DerULF1/8bit-computer/Schematics/memory2.pdf

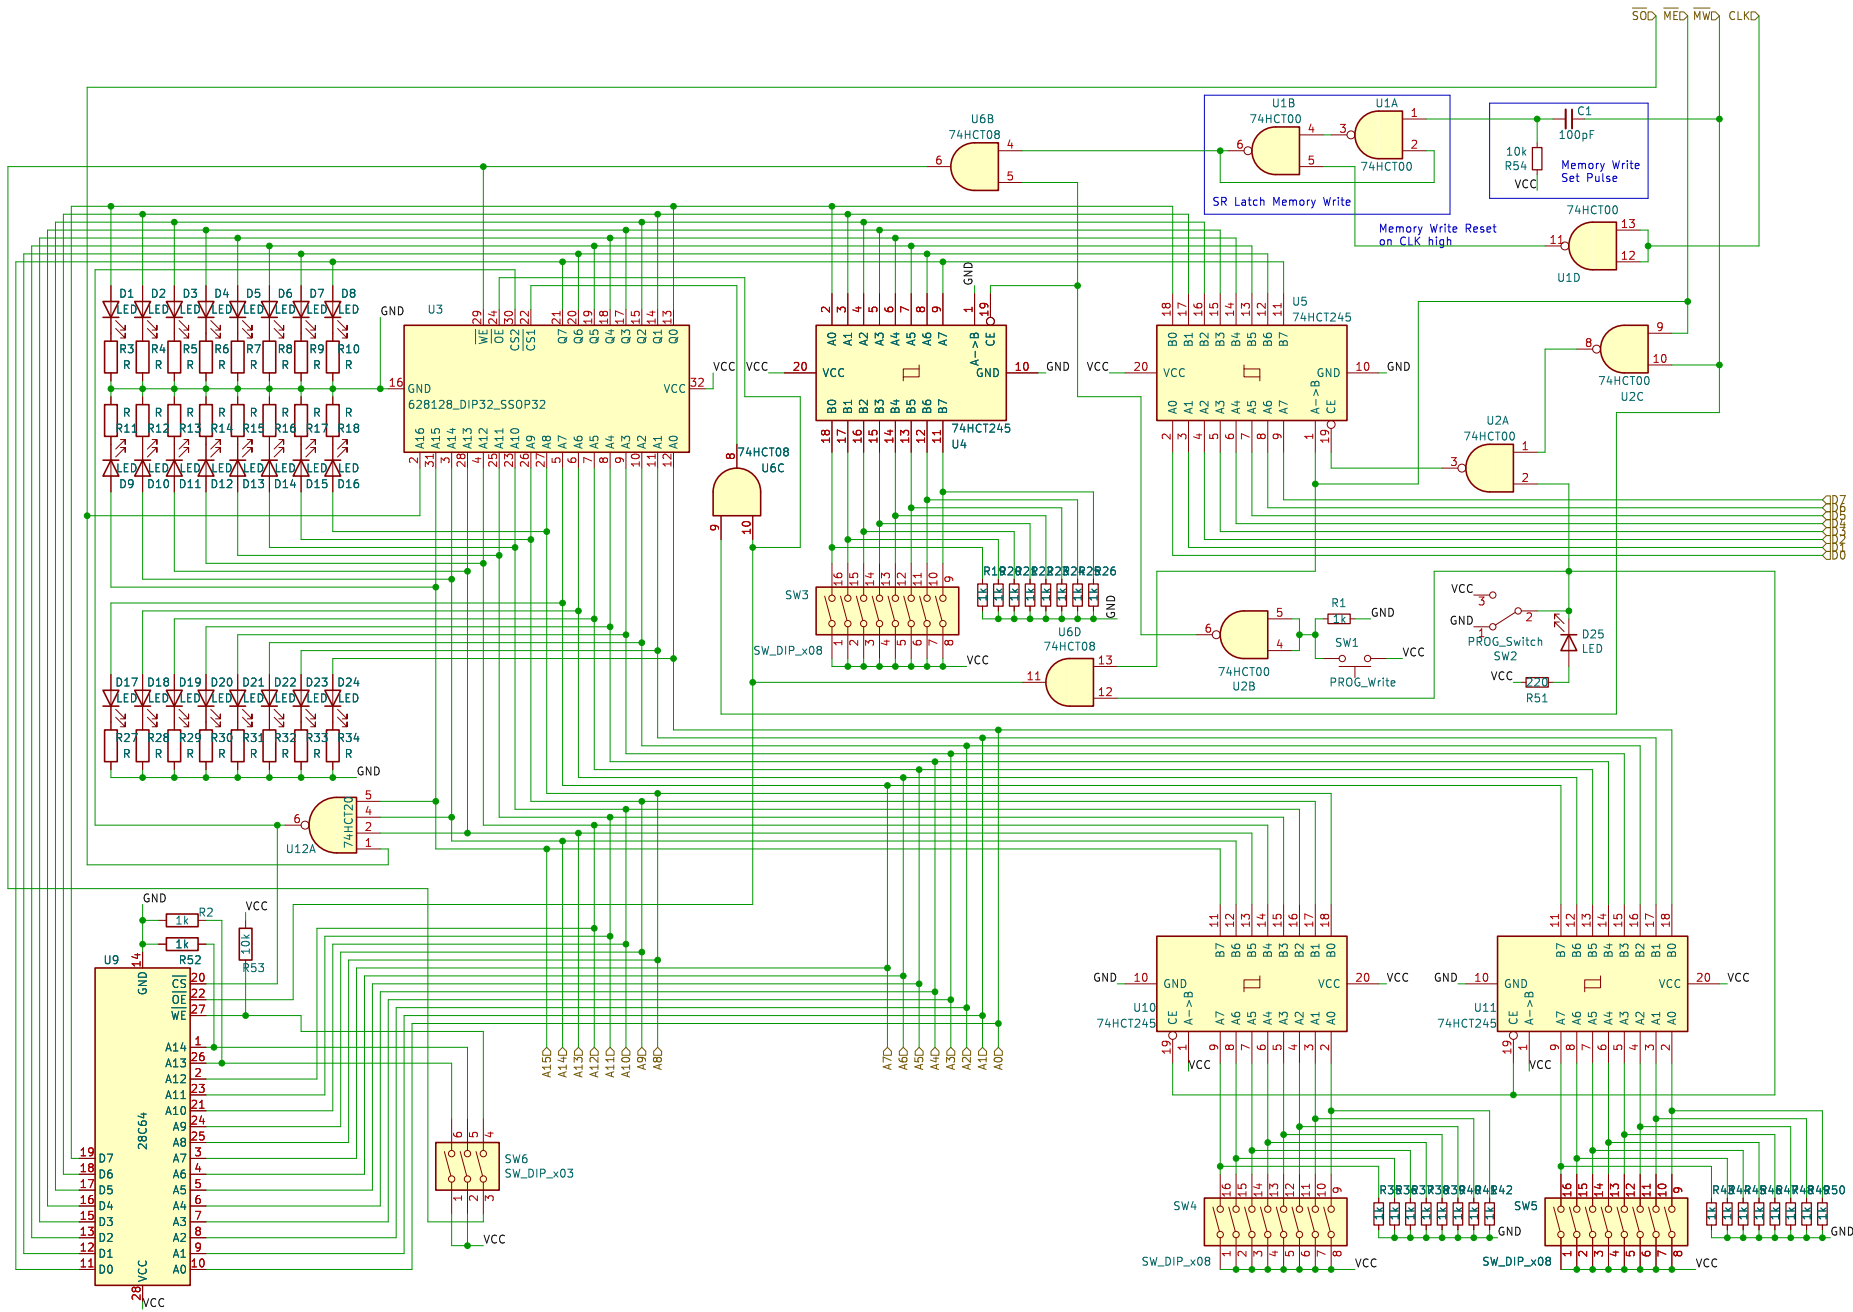
[picture p1: page 1]
