DerULF1/8bit-computer/Schematics/StackAddress2.pdf

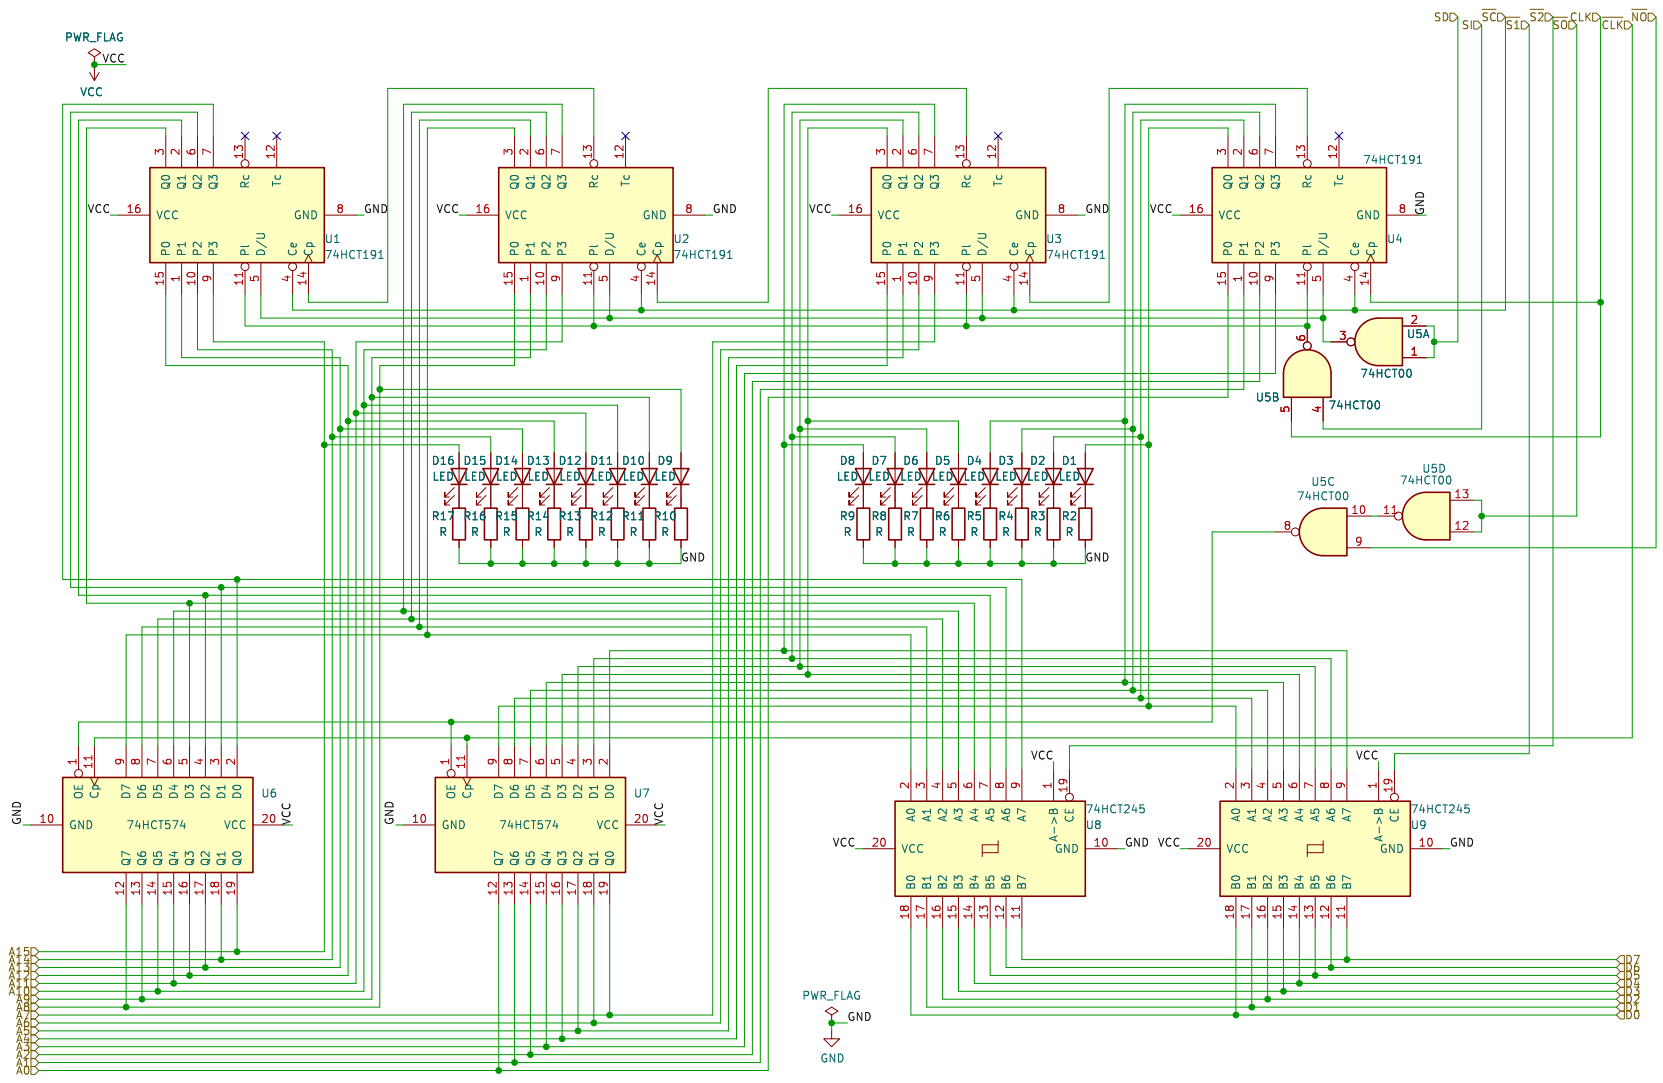
[picture p2: page 1]
