DerULF1/8bit-computer/Schematics/NewAddress2.pdf

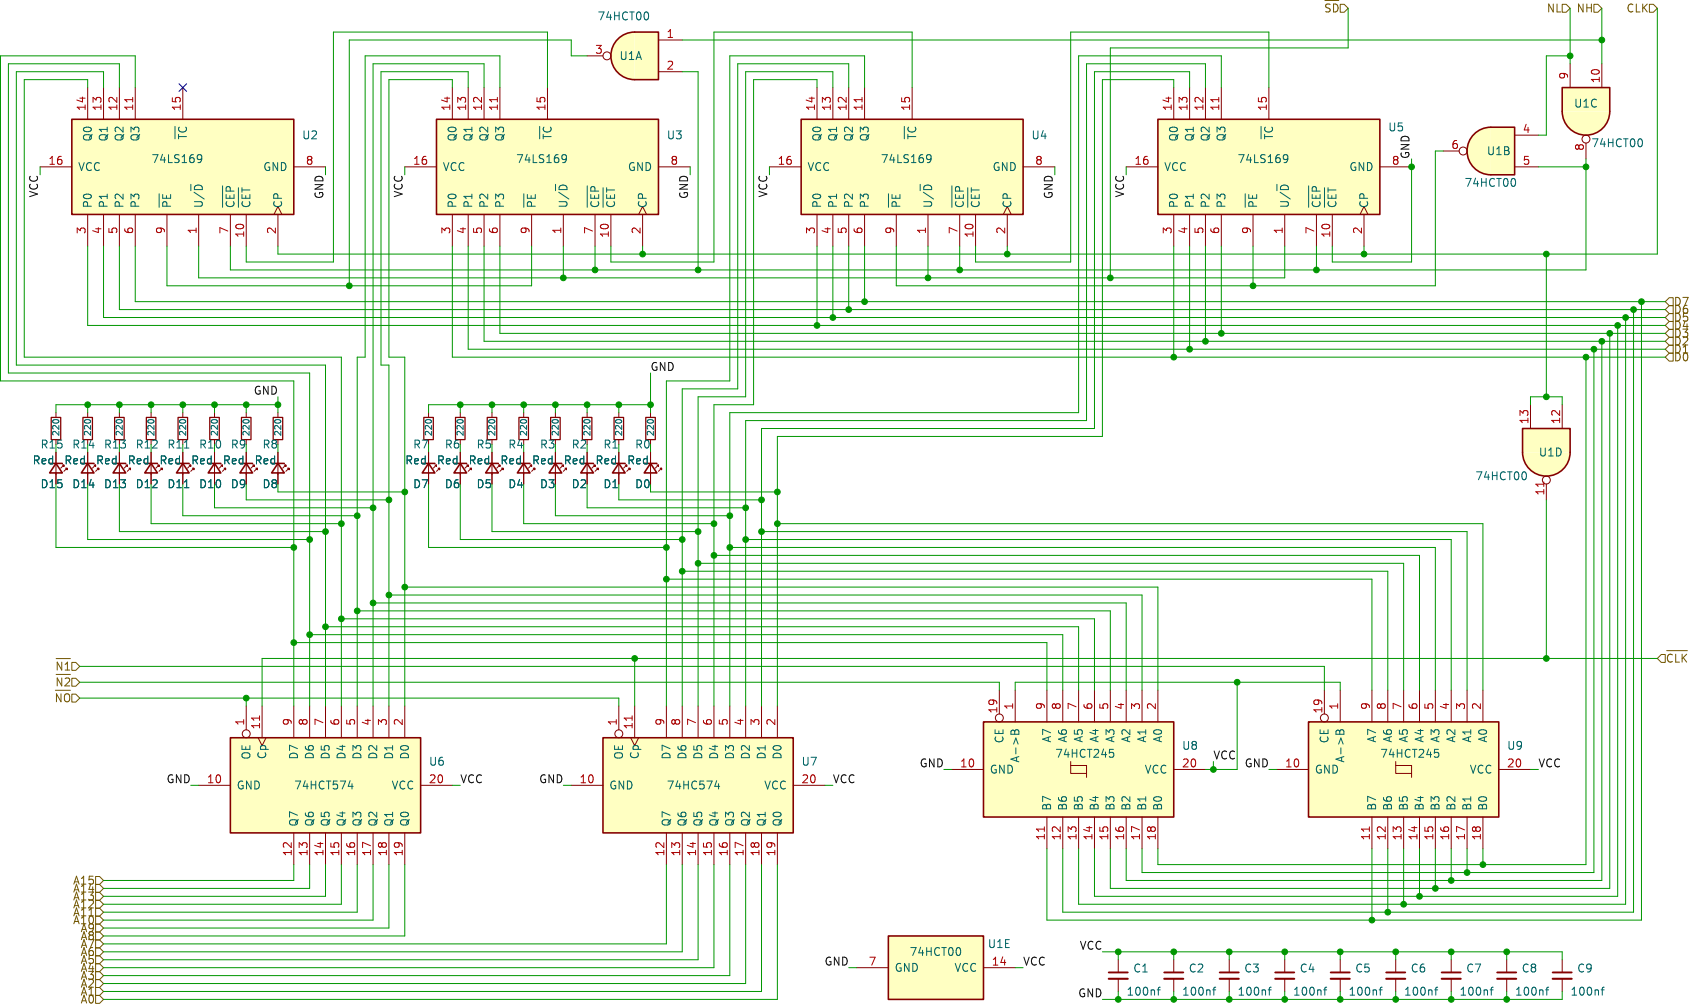
[picture p3: page 1]
