DerULF1/8bit-computer/Schematics/EEPROMer.pdf

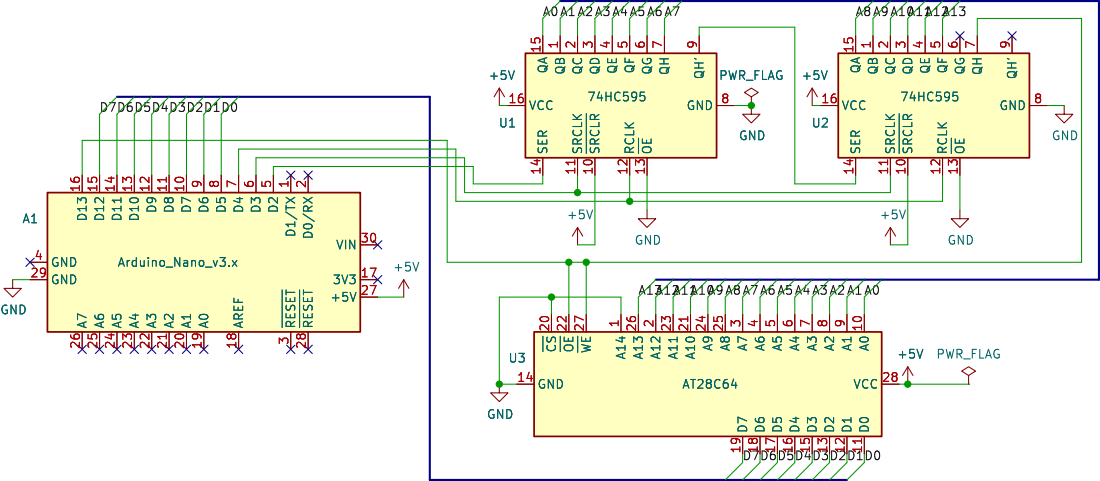
[picture p4: page 1]
