DerULF1/8bit-computer/Schematics/EEPROMer4M.pdf

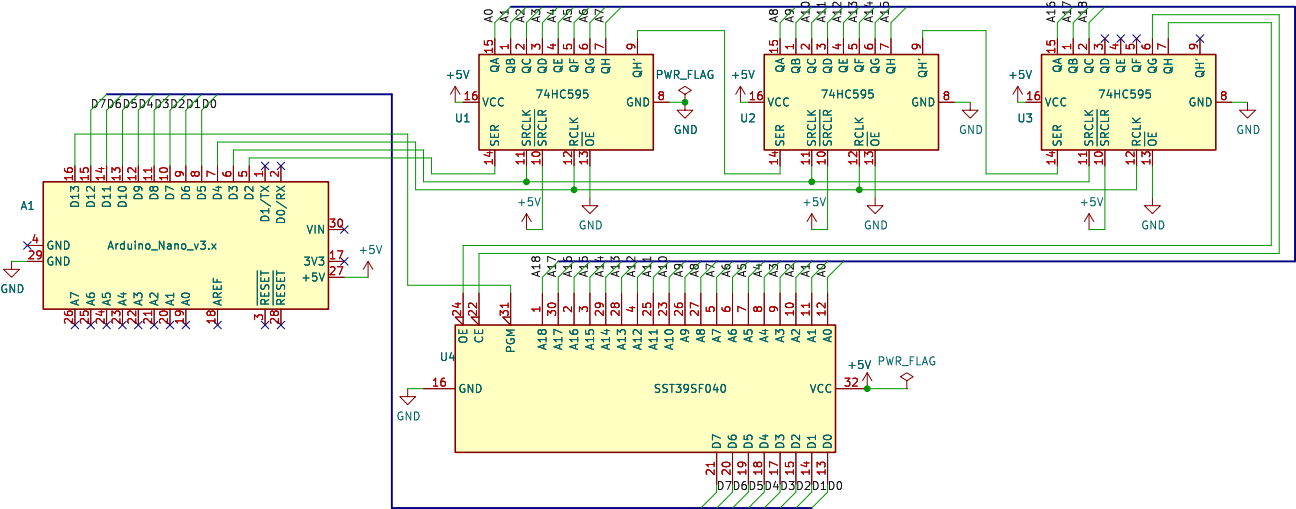
[picture p5: page 1]
