DerULF1/8bit-computer/Schematics/memory.pdf

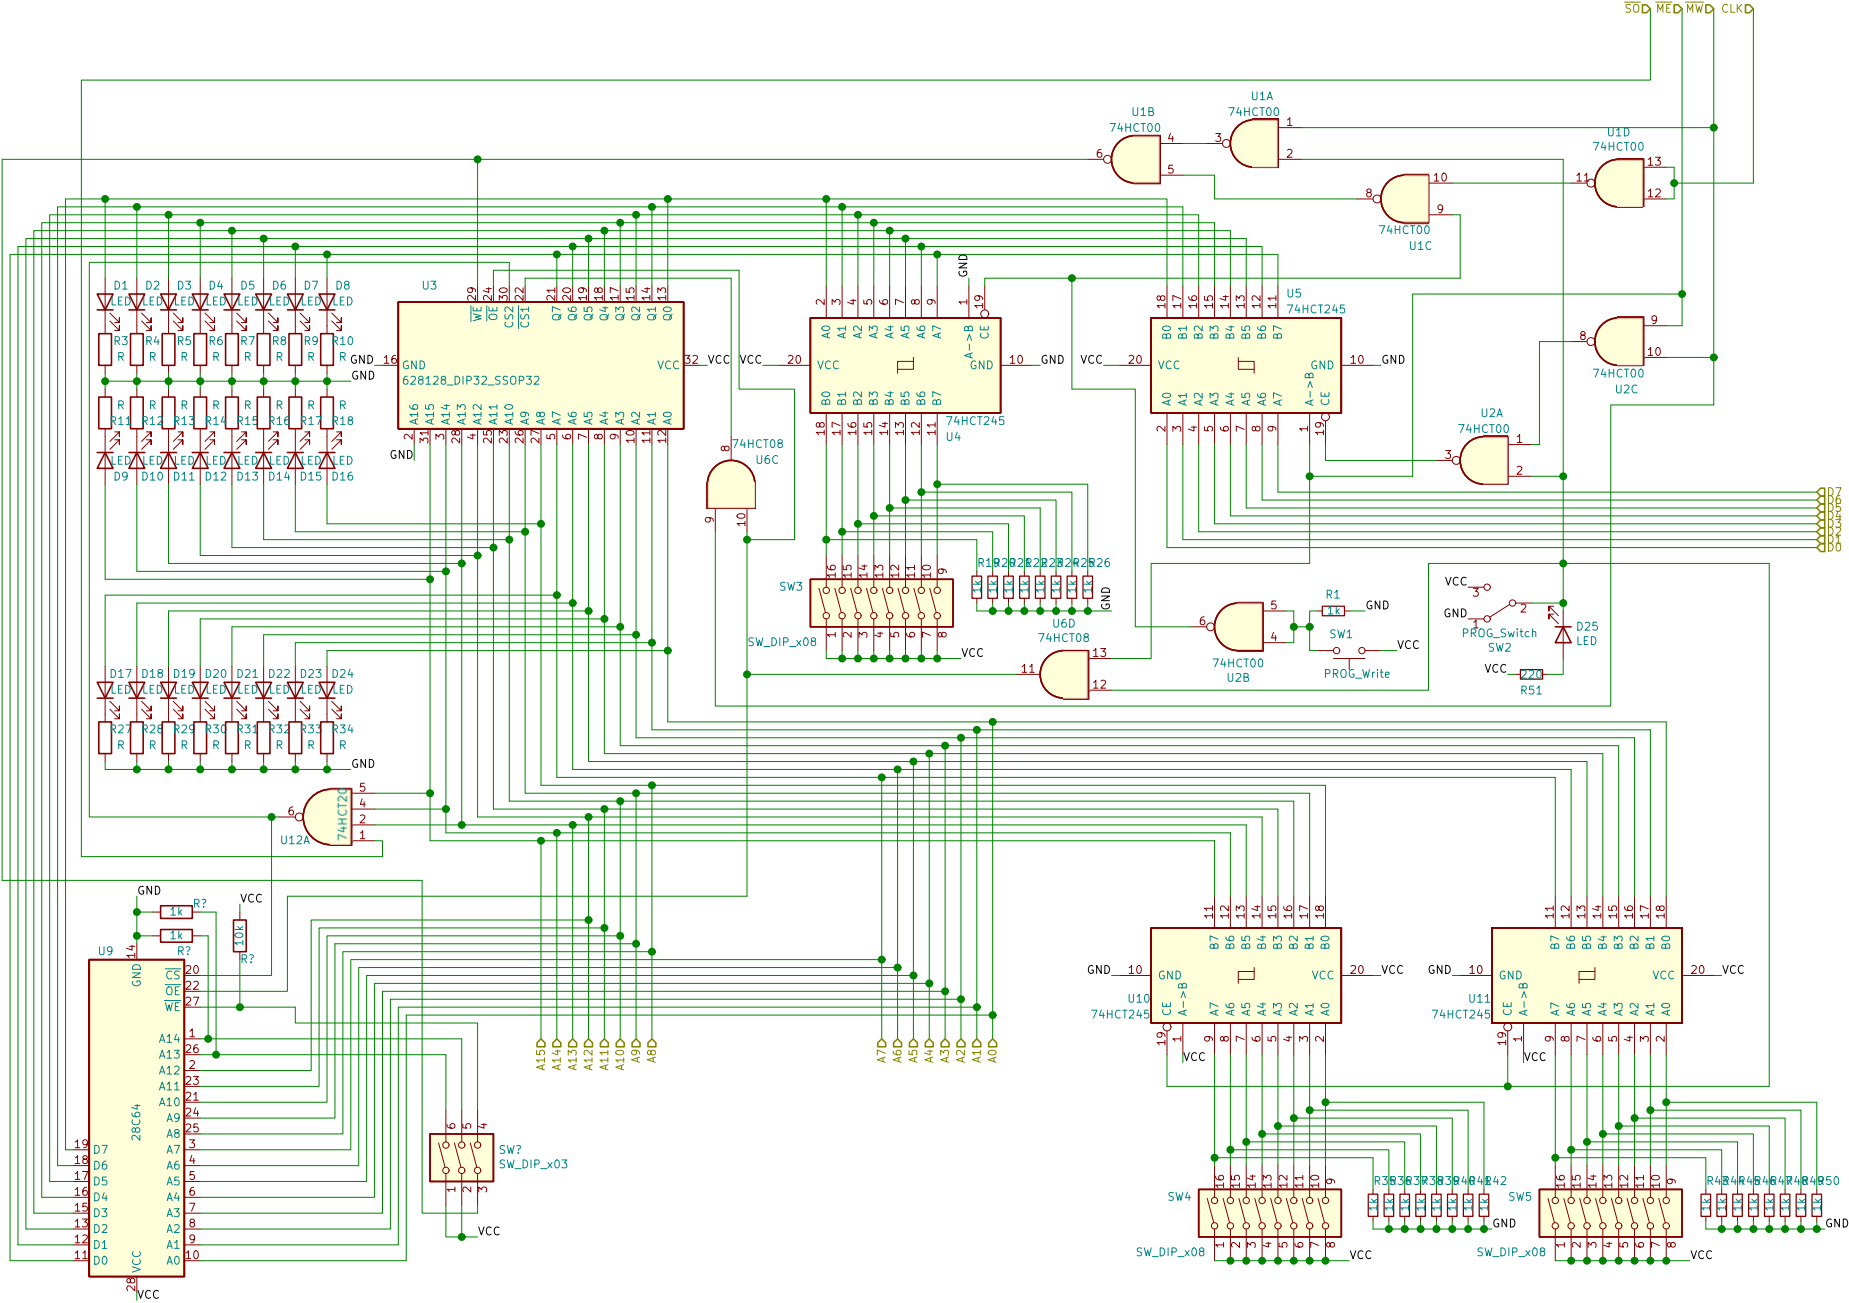
[picture p6: page 1]
