DerULF1/8bit-computer/Schematics/Clock.pdf

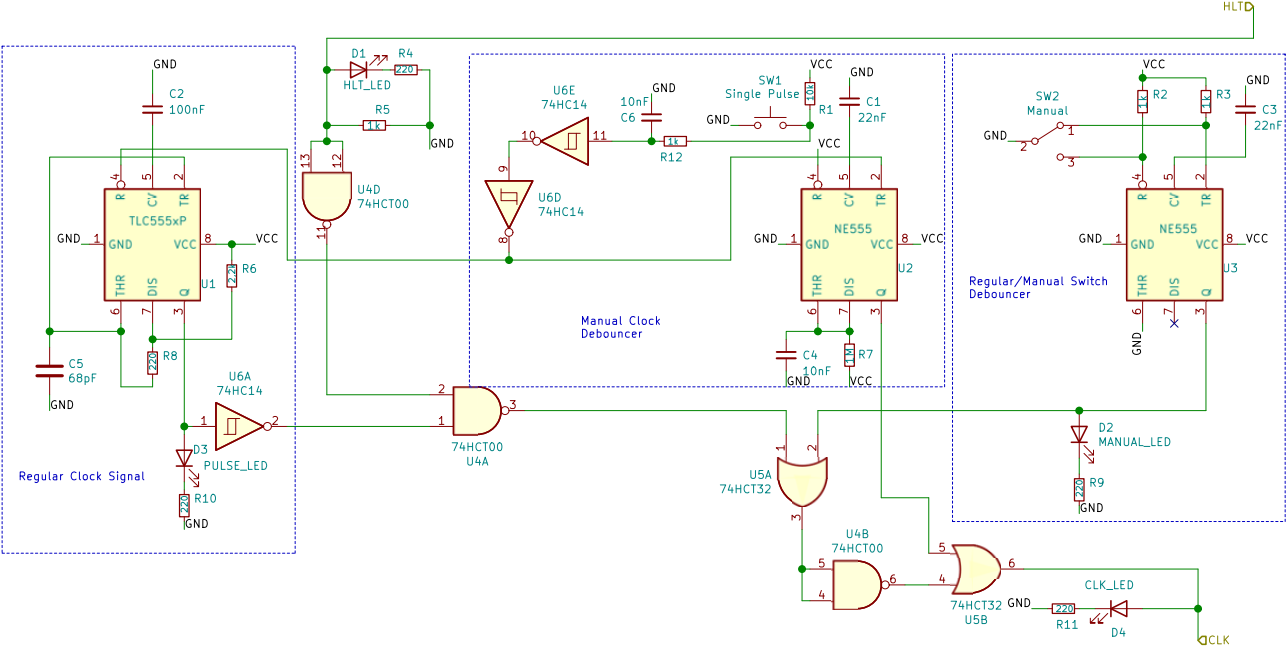
[picture p7: page 1]
