DerULF1/8bit-computer/Schematics/ControlLogic.pdf

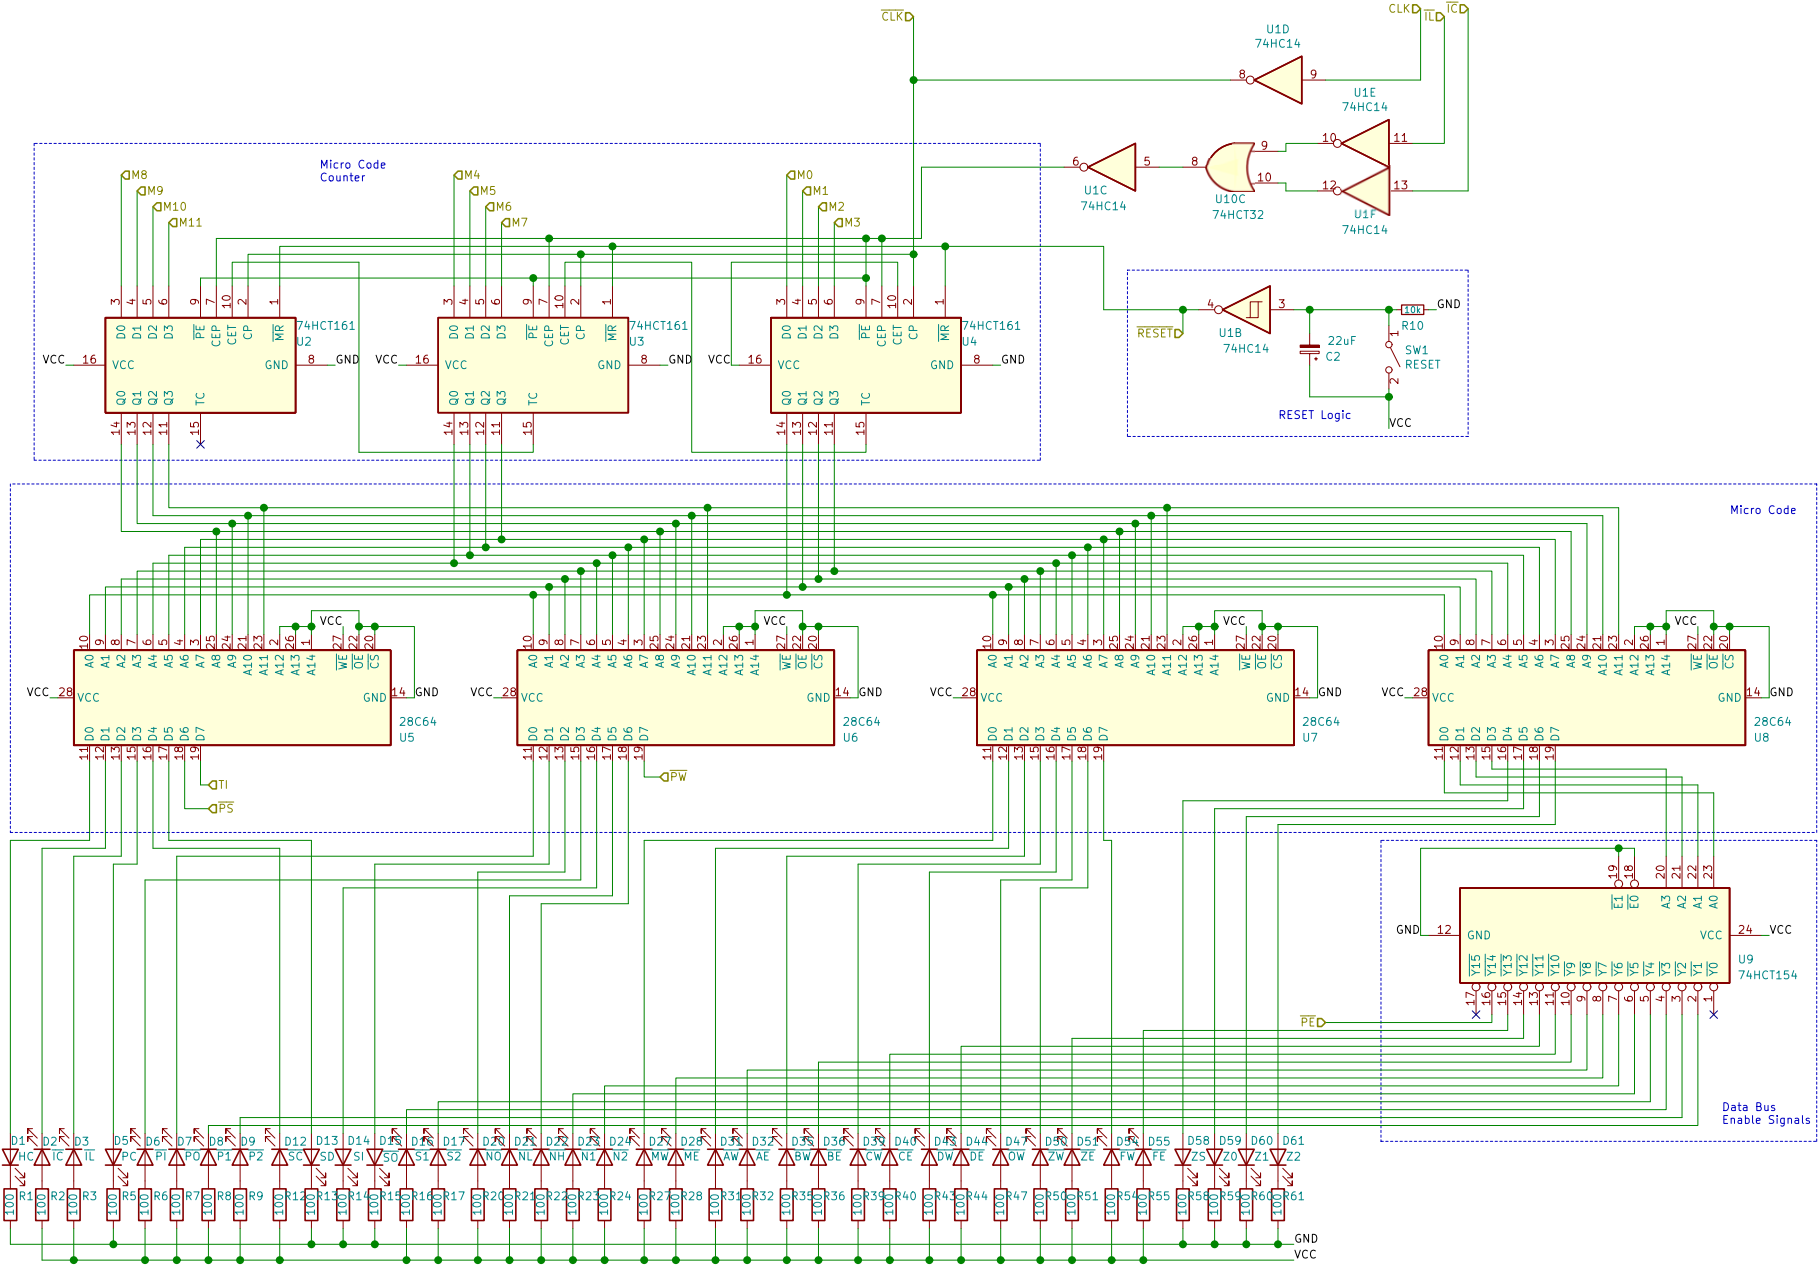
[picture p8: page 1]
