DerULF1/8bit-computer/Schematics/InstructionDecoder.pdf

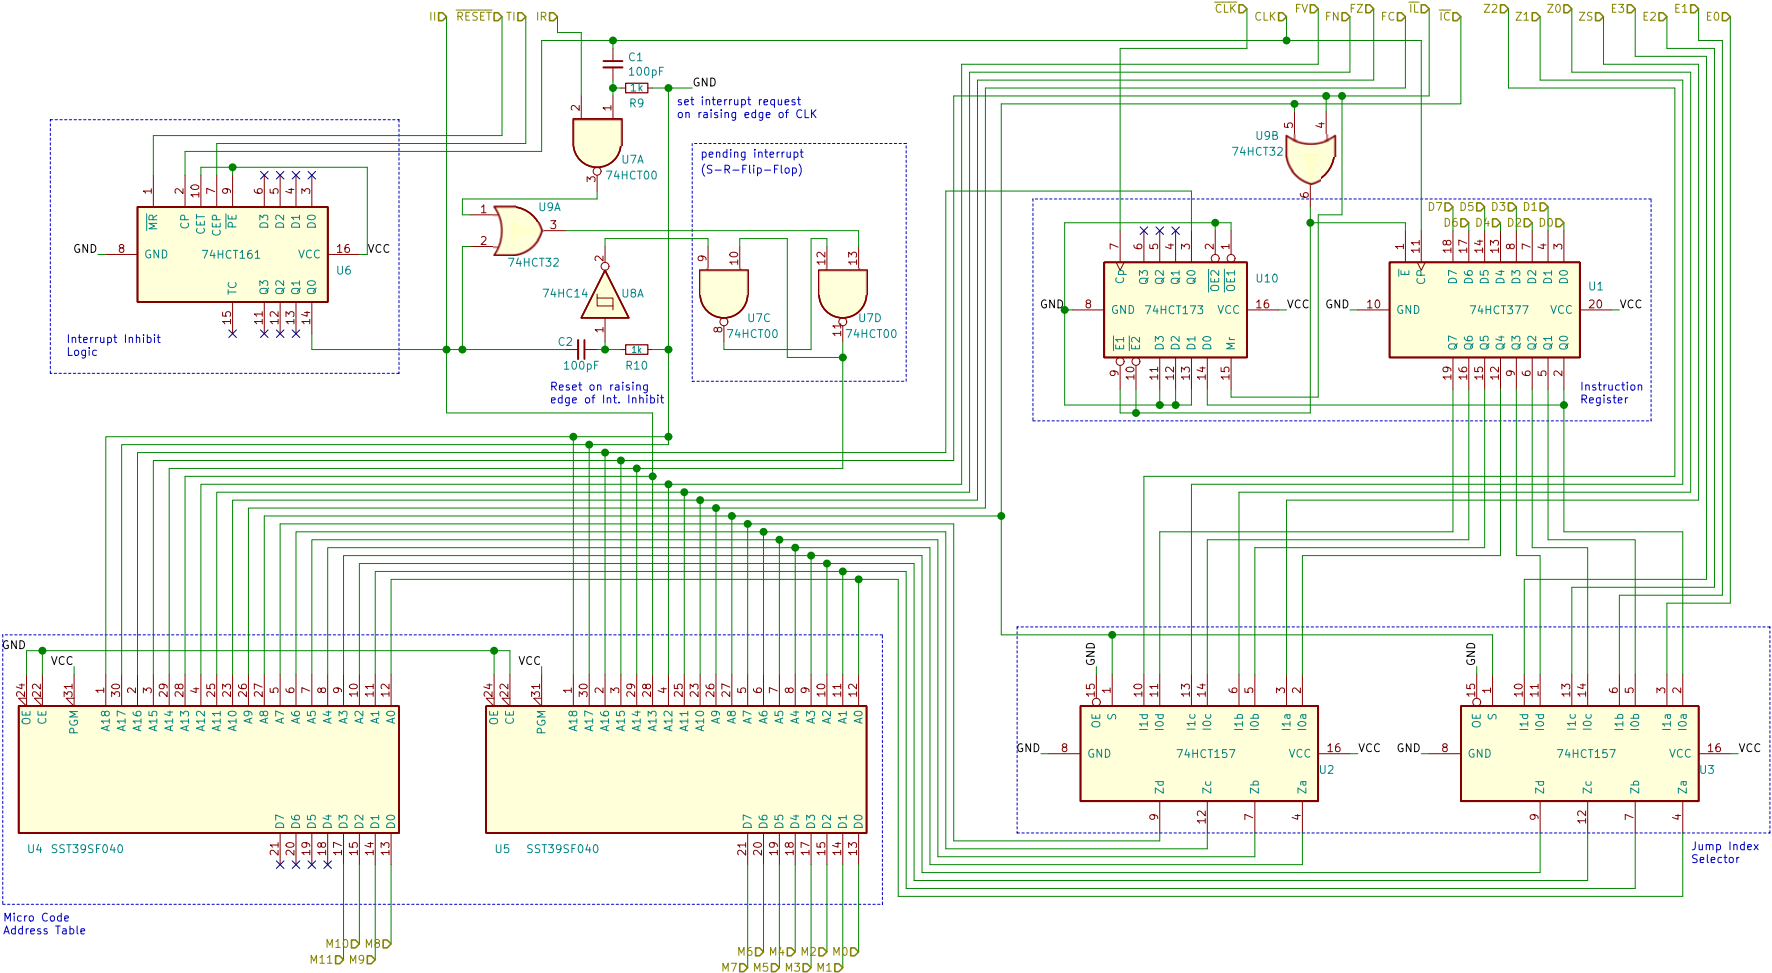
[picture p9: page 1]
