DerULF1/8bit-computer/Schematics/PS2Controler.pdf

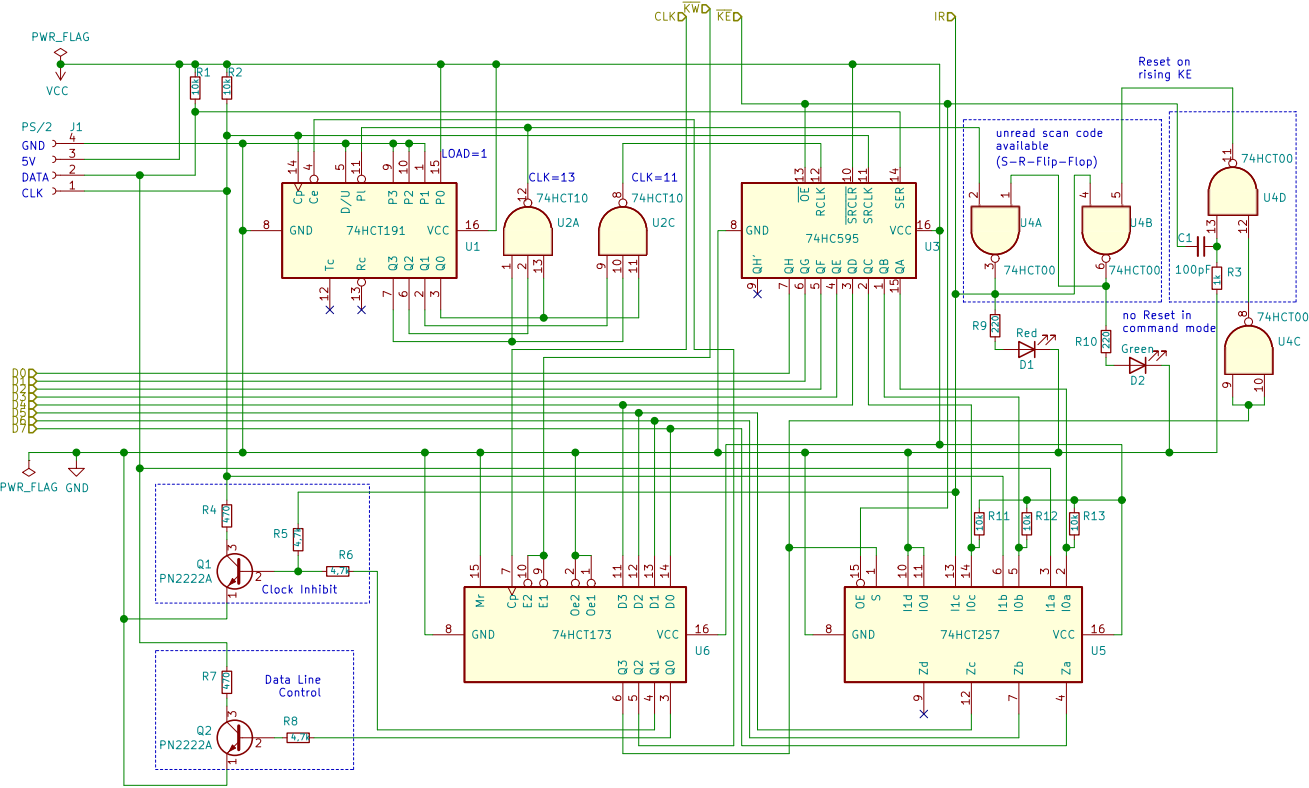
[picture p10: page 1]
