DerULF1/8bit-computer/Schematics/SPI.pdf

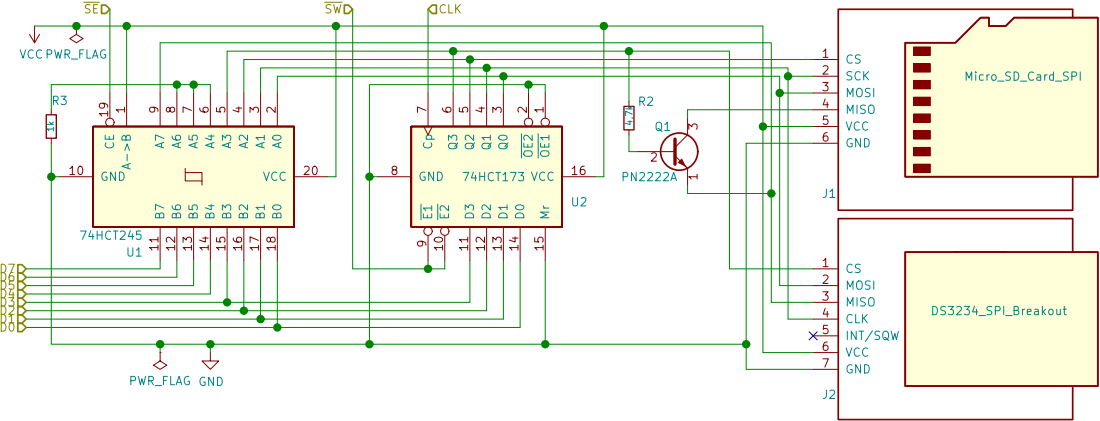
[picture p11: page 1]
