DerULF1/8bit-computer/Schematics/ALU.pdf

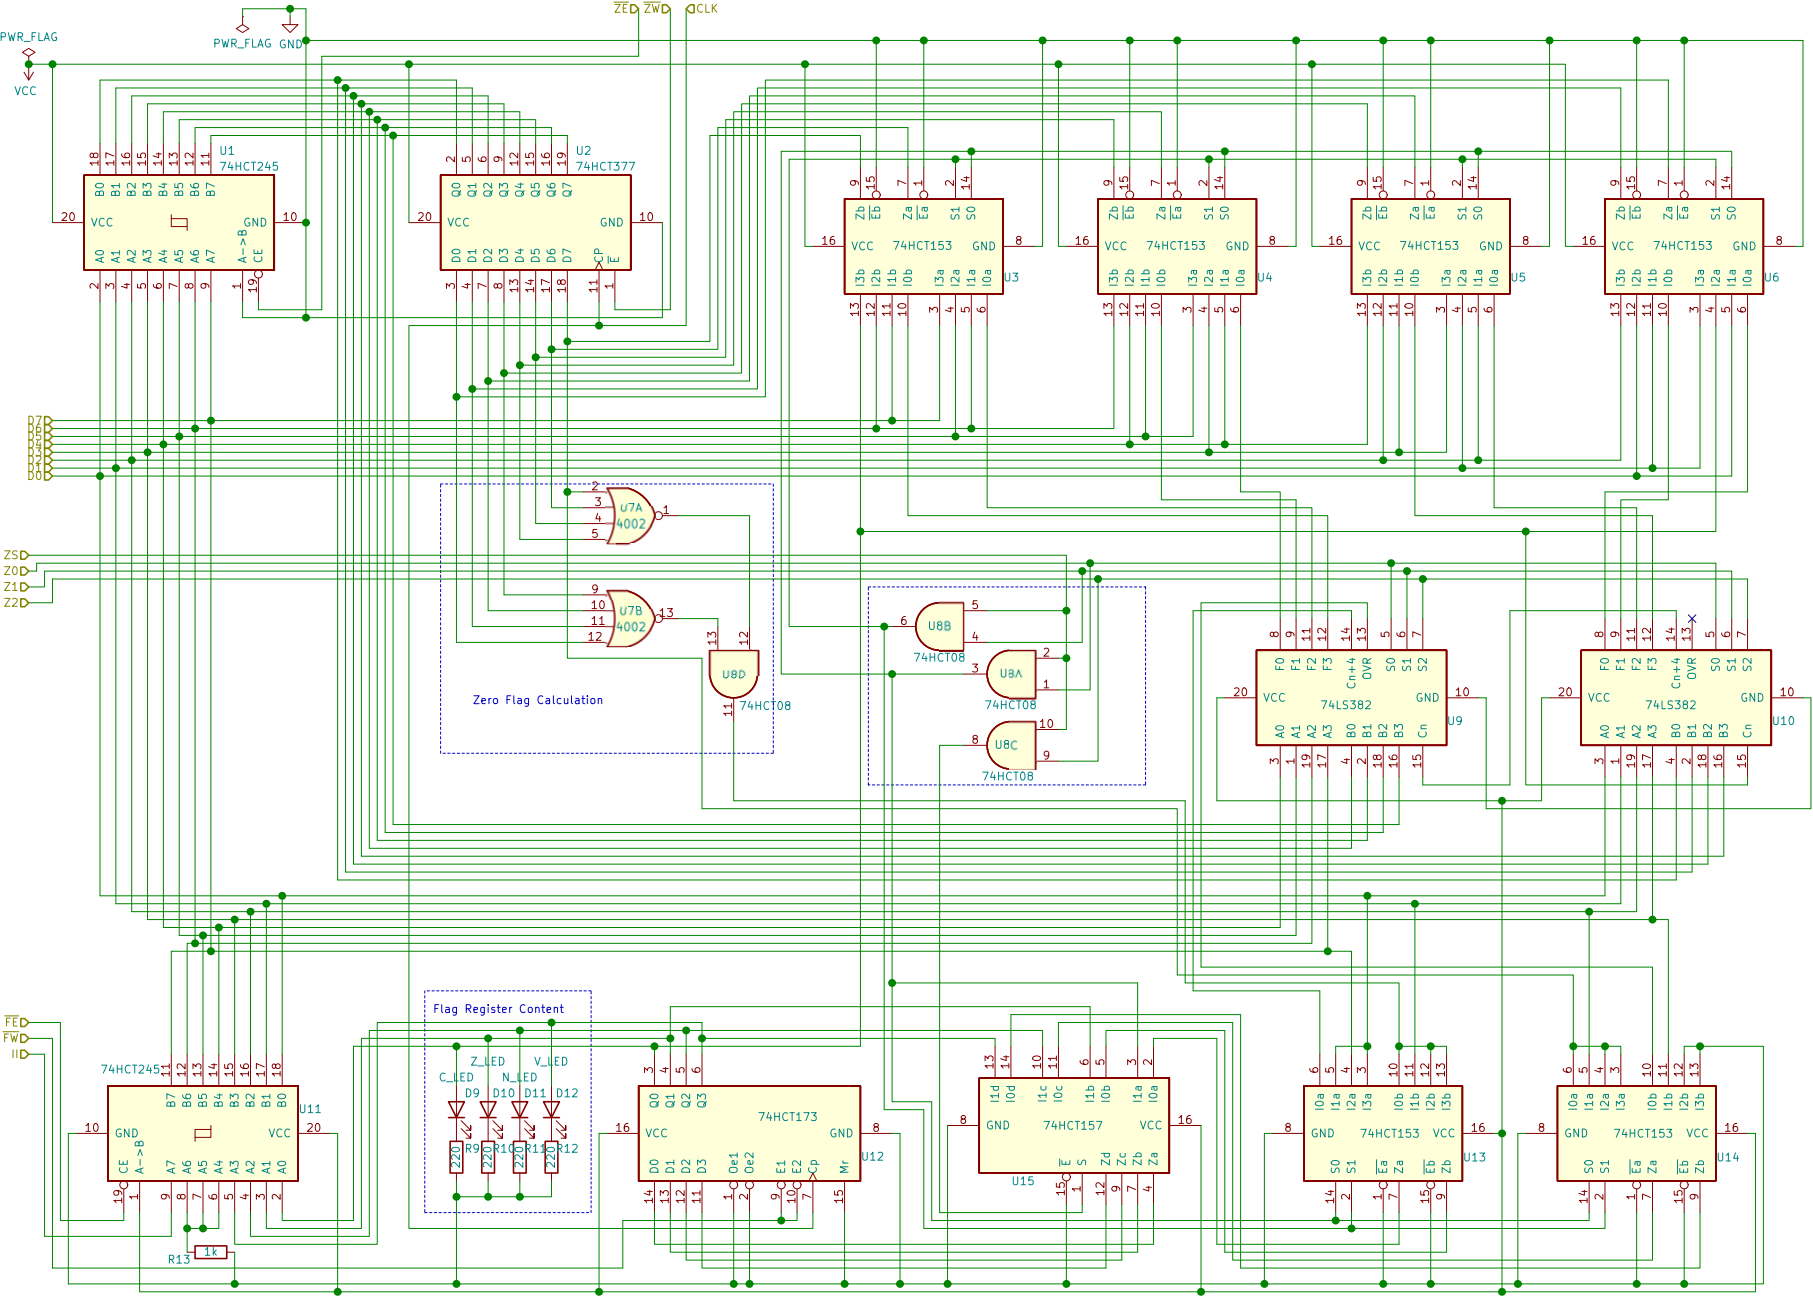
[picture p12: page 1]
