DerULF1/8bit-computer/Schematics/7Segment.pdf

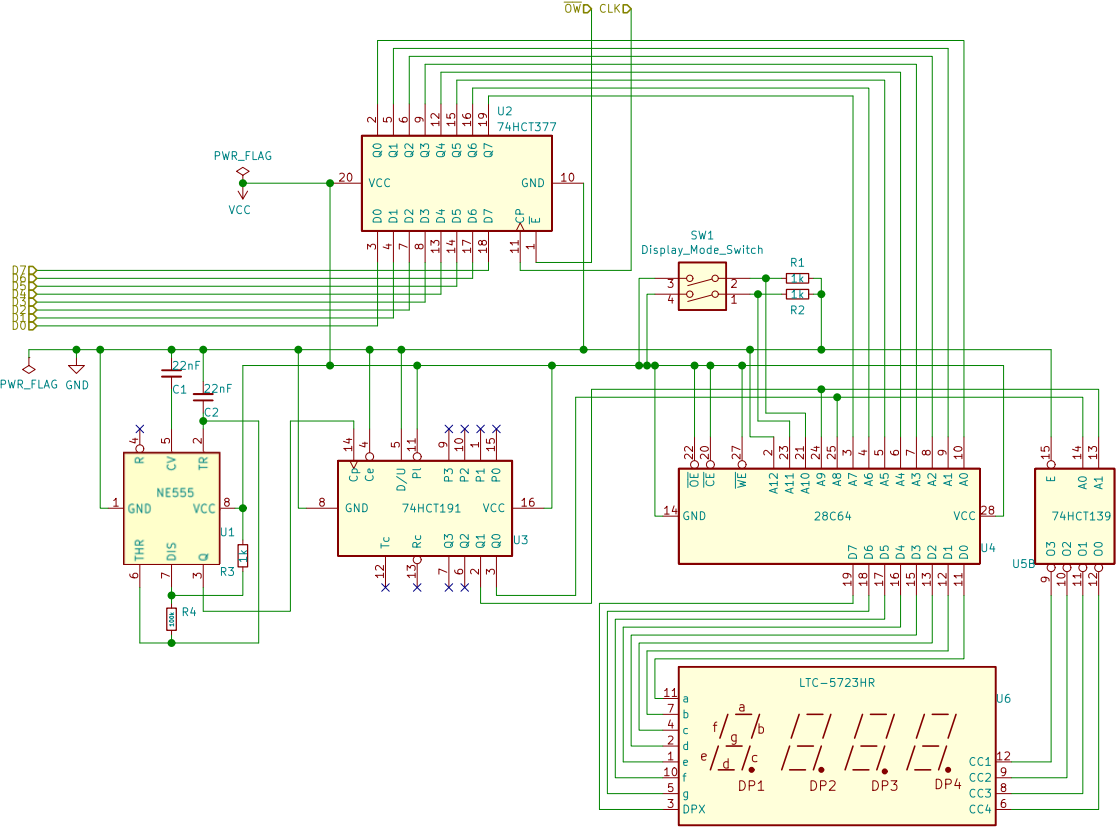
[picture p13: page 1]
