DerULF1/8bit-computer/Schematics/LCD.pdf

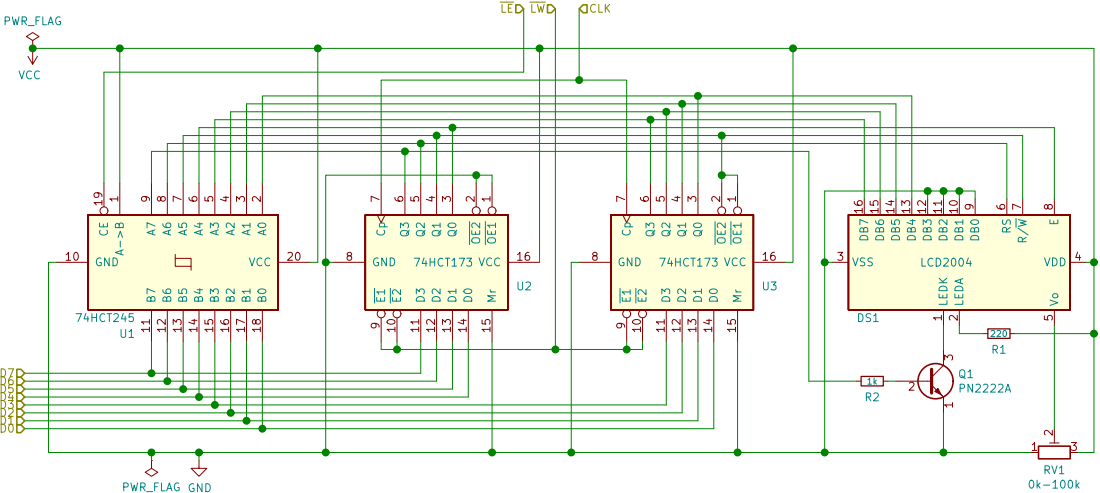
[picture p14: page 1]
