DerULF1/8bit-computer/Schematics/NewAddress.pdf

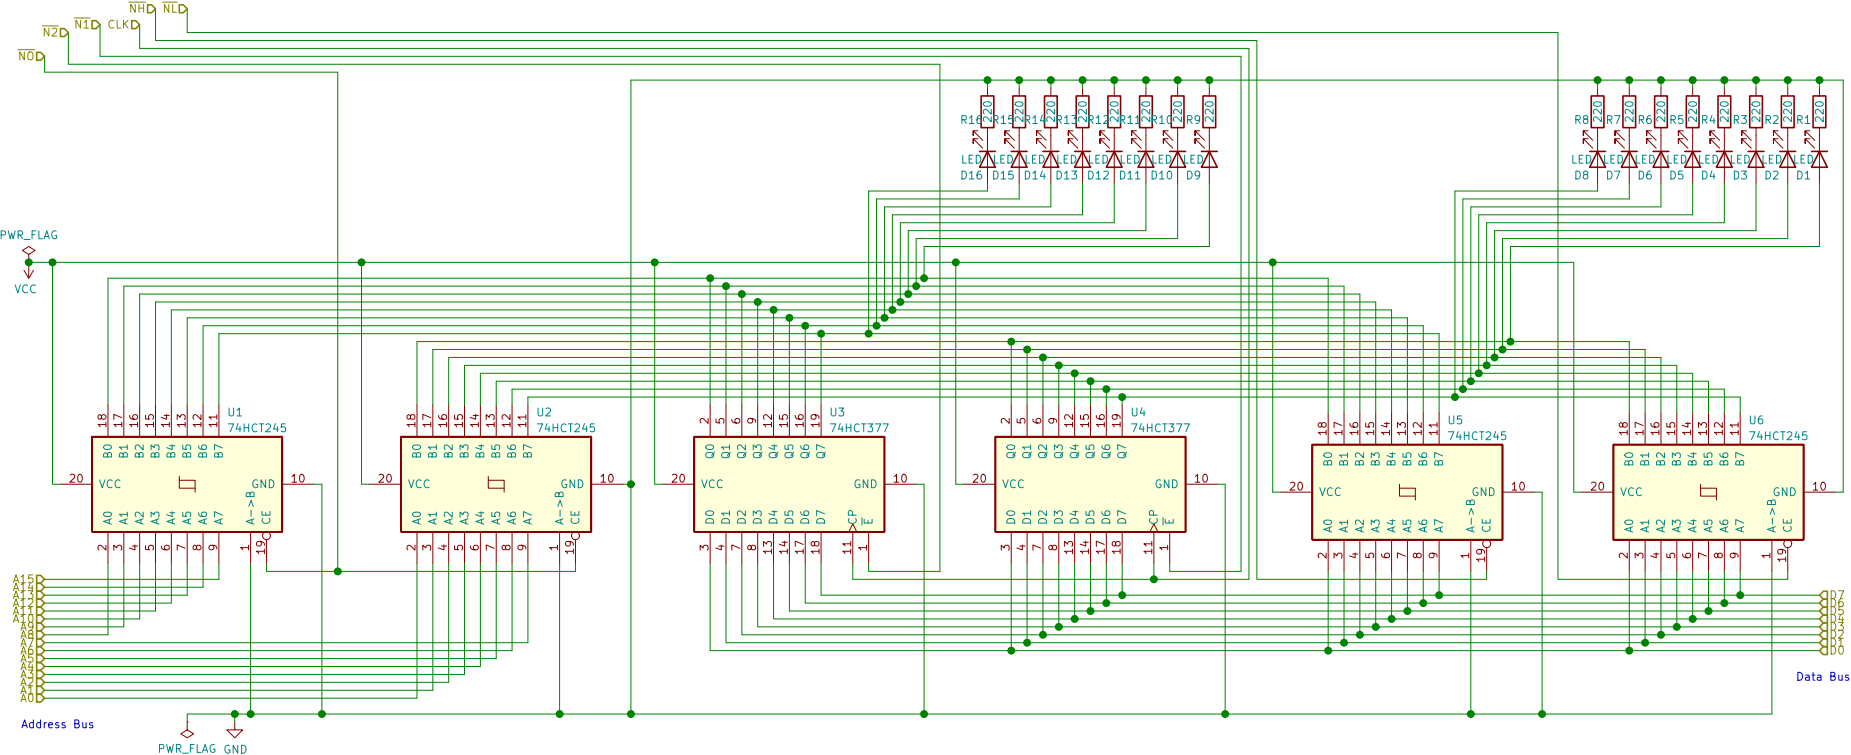
[picture p15: page 1]
