DerULF1/8bit-computer/Schematics/PortSelector.pdf

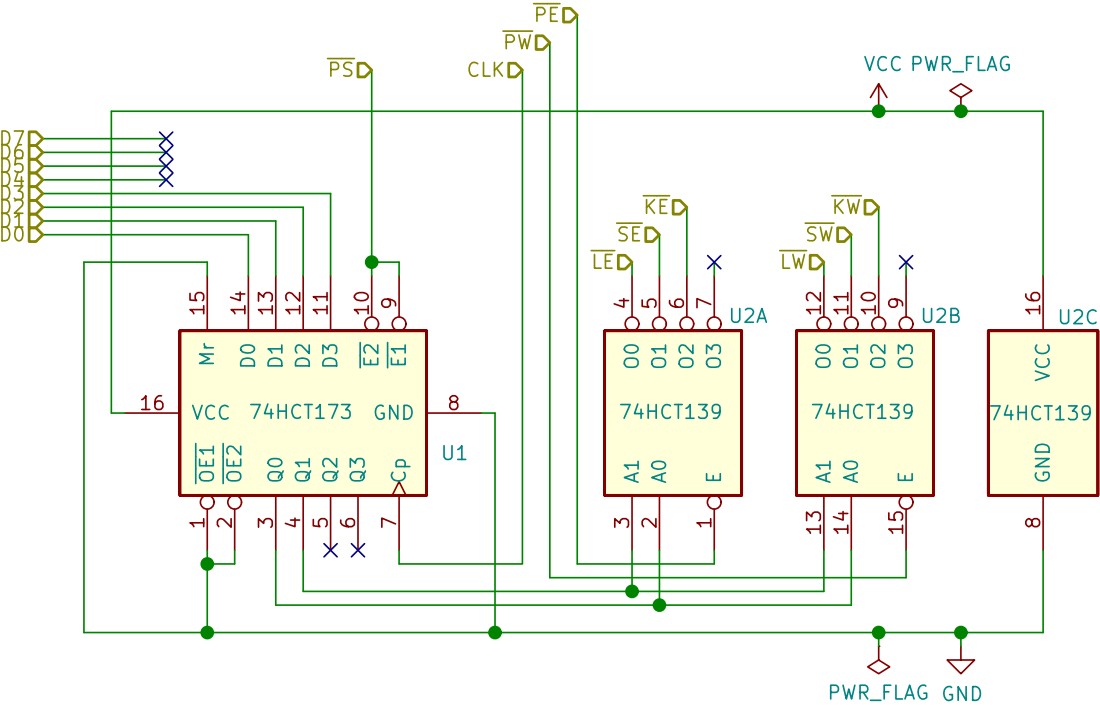
[picture p16: page 1]
