DerULF1/8bit-computer/Schematics/ProgramCounter.pdf

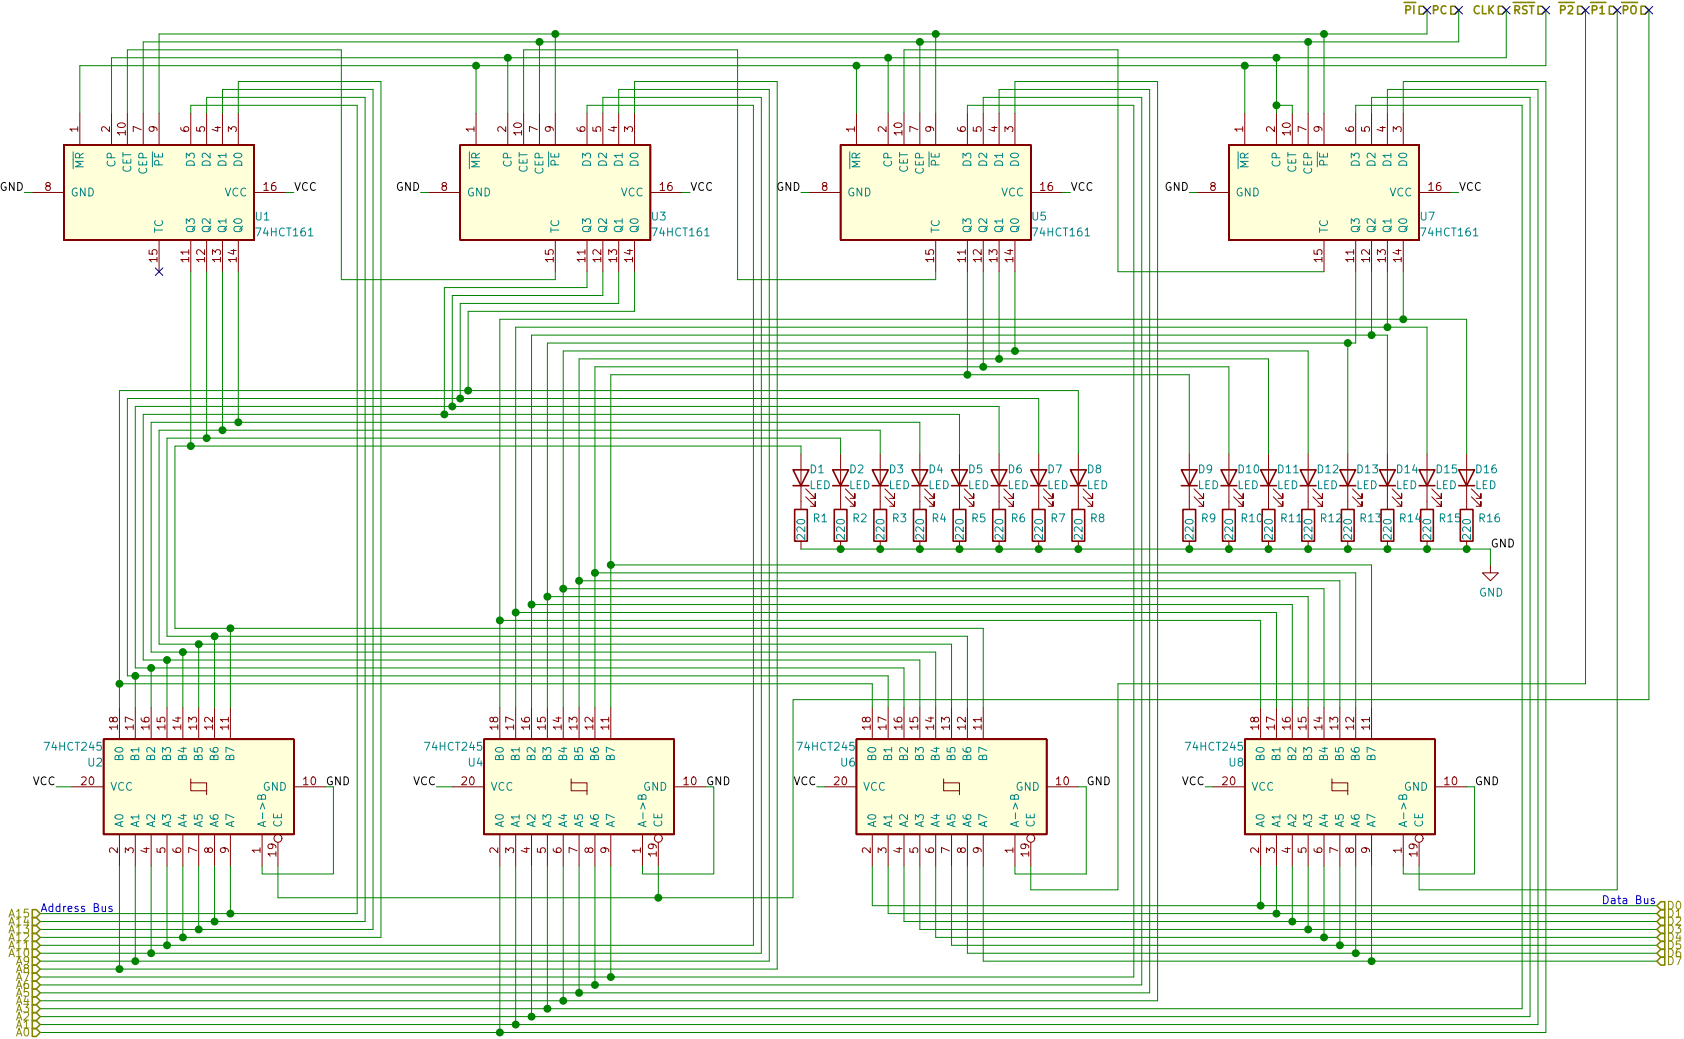
[picture p17: page 1]
