DerULF1/8bit-computer/Schematics/Register.pdf

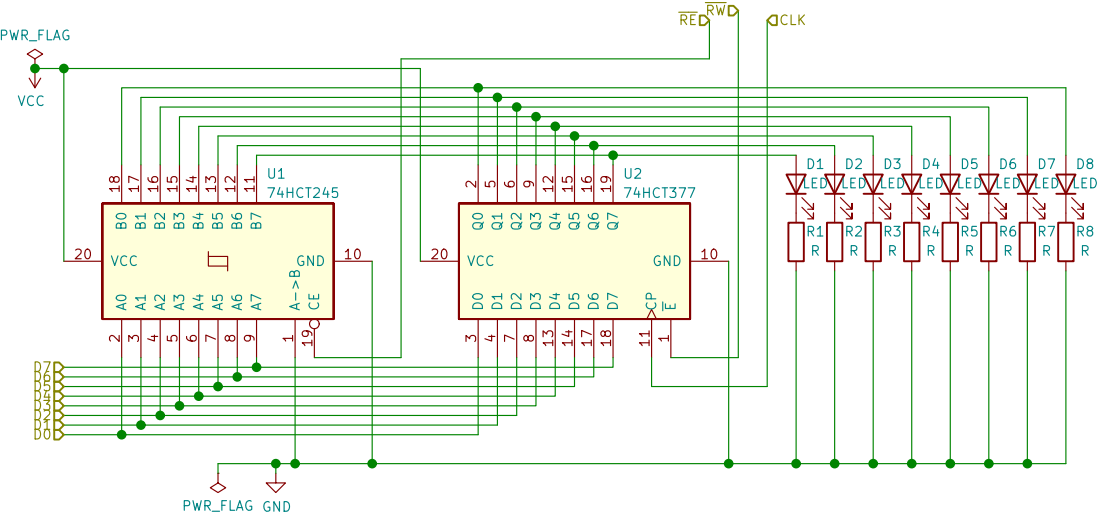
[picture p18: page 1]
