DerULF1/8bit-computer/Schematics/StackAddress.pdf

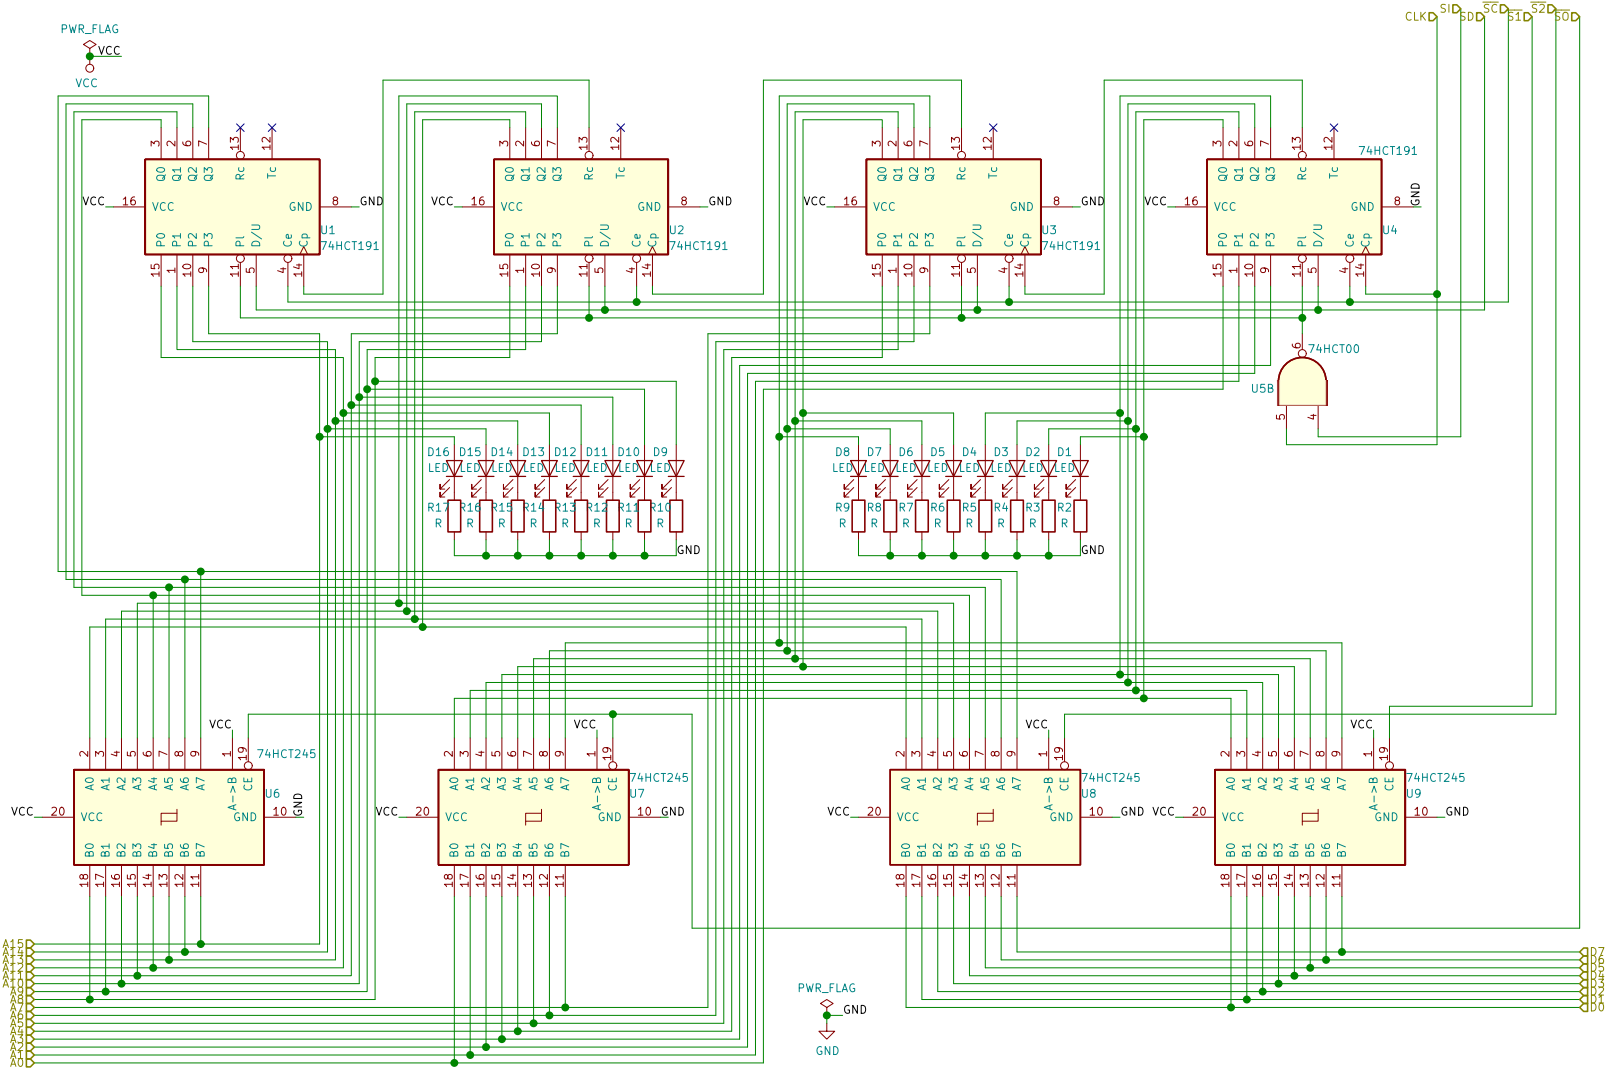
[picture p19: page 1]
