DerULF1/8bit-computer/Sketches/EEPROMOS/EEPROMOS.ino

#define SHIFT_DATA 2
#define SHIFT_CLK 3
#define SHIFT_LATCH 4
#define DATA_D0 5
#define DATA_D7 12
#define EEPROM_D0 5
#define EEPROM_D7 12
#define WRITE_ENABLE 13

#define READ true     // for the setAddress procedure
#define WRITE false   // for the setAddress procedure
#define DISABLE false     // for the setAddress procedure
#define ENABLE true   // for the setAddress procedure

int writeErrors = 0;

void writeByte(int address, byte odata) {
  setDataPinMode(OUTPUT);
  
  setAddress(address, ENABLE, WRITE);

  byte data = odata;
  for (int pin = EEPROM_D7; pin >= EEPROM_D0; pin--) {
    digitalWrite(pin, data & 0x80);
    data = data << 1;
  }
  digitalWrite(WRITE_ENABLE, LOW);  
  delayMicroseconds(1);
  digitalWrite(WRITE_ENABLE, HIGH);
}

void writeEEPROM(int address, byte odata) {
  byte old = readEEPROM(address);
  if (old != odata) {
    writeByte(address, odata);

  /*  delay(15);*/
    int cnt = 1000;
    byte l;
    do {
      setAddress(address, DISABLE, READ);
      cnt--;
      l = readEEPROM(address);
    } while ((cnt > 0) && (l != odata)); 
    if (cnt == 0){

    /*if (l != odata){*/
      char buf[60];
      sprintf(buf, "\r\nWRITE ERROR on %04x! (%02x %02x)\r\n", address, odata, l);
      Serial.println(buf);
      writeErrors++;
      }
  }
}

byte readEEPROM(int address) {
  setDataPinMode(INPUT);  
  
  setAddress(address, ENABLE, READ);
  
  byte data = 0;
  for (int pin = EEPROM_D7; pin >= EEPROM_D0; pin--) {
    data = data * 2 + digitalRead(pin);
  }
  return data;
}

void setAddress(int address, boolean chipEnable, boolean outputEnable) {
/*  shiftOut(SHIFT_DATA, SHIFT_CLK, MSBFIRST, (address >> 8) | (outputEnable ? 0 : 0x80));*/
  shiftOut(SHIFT_DATA, SHIFT_CLK, MSBFIRST, (address >> 8) | (chipEnable ? 0 : 0x40) | (outputEnable ? 0 : 0x80));   
  shiftOut(SHIFT_DATA, SHIFT_CLK, MSBFIRST, address);
  
  digitalWrite(SHIFT_LATCH, LOW);
  digitalWrite(SHIFT_LATCH, HIGH);
  digitalWrite(SHIFT_LATCH, LOW);  
}

void setDataPinMode(int mode) {
  for (int pin = EEPROM_D7; pin >= EEPROM_D0; pin--) {
    pinMode(pin, mode);
  }  
}

void initPorts() {
  digitalWrite(WRITE_ENABLE, HIGH);  
  digitalWrite(SHIFT_LATCH, LOW);
  pinMode(SHIFT_DATA, OUTPUT);
  pinMode(SHIFT_CLK, OUTPUT);
  pinMode(SHIFT_LATCH, OUTPUT);
  pinMode(WRITE_ENABLE, OUTPUT);
}

void unlock() {
  writeByte(0x5555, 0xAA);
  setAddress(0x5555, DISABLE, WRITE);
  writeByte(0x2AAA, 0x55);
  setAddress(0x2AAA, DISABLE, WRITE);
  writeByte(0x5555, 0x80);
  setAddress(0x5555, DISABLE, WRITE);
  writeByte(0x5555, 0xAA);
  setAddress(0x5555, DISABLE, WRITE);
  writeByte(0x2AAA, 0x55);
  setAddress(0x2AAA, DISABLE, WRITE);
  writeByte(0x5555, 0x20);
  setAddress(0x5555, DISABLE, WRITE);
  writeByte(0x0000, 0xFE);
  setAddress(0x0000, DISABLE, WRITE);
  writeByte(0x0000, 0xFE);
  setAddress(0x0000, DISABLE, WRITE);
}

void printContents(int baseAddress) {
  for (int base = 0; base <= 255; base += 16) {
    byte data[16];
    for (int offset = 0; offset <= 15; offset++) {
      data[offset] = readEEPROM(baseAddress + base + offset);
    }

    char buf[80];
    sprintf(buf, "%04x: %02x %02x %02x %02x %02x %02x %02x %02x  %02x %02x %02x %02x %02x %02x %02x %02x",
            baseAddress + base, data[0], data[1], data[2], data[3], data[4], data[5], data[6], data[7], data[8],
            data[9], data[10], data[11], data[12], data[13], data[14], data[15]);

    Serial.println(buf);
  }
}

// OS
const byte opgmData[] PROGMEM = {
  /* 0x0100 */ 0xca, 0xc4, 0xc4, 0xc4, 0xc4, 0xd7, 0x09, 0xe0, 0xcb, 0x5f, 0x0f, 0x02, 0x5d, 0x30, 0x03, 0x62, 
  /* 0x0110 */ 0x3a, 0xdc, 0x47, 0xe0, 0x02, 0x5d, 0x07, 0xd6, 0x47, 0xe0, 0xd7, 0xcd, 0xe1, 0x98, 0x5f, 0xff, 
  /* 0x0120 */ 0xd9, 0x2e, 0xe0, 0xd7, 0x47, 0xe0, 0x02, 0x6b, 0x01, 0x72, 0x00, 0xdc, 0x1d, 0xe0, 0x06, 0x63, 
  /* 0x0130 */ 0x00, 0x02, 0x6a, 0x43, 0x33, 0x71, 0xe0, 0x72, 0x00, 0x98, 0x09, 0x81, 0x01, 0xc0, 0x60, 0x80, 
  /* 0x0140 */ 0xd6, 0x3e, 0xe2, 0x00, 0x40, 0x14, 0x54, 0x03, 0x62, 0x08, 0xd9, 0x7c, 0xe0, 0x03, 0x62, 0x0a, 
  /* 0x0150 */ 0xd9, 0x6f, 0xe0, 0x03, 0x62, 0x0d, 0xd9, 0x6b, 0xe0, 0xd7, 0x6e, 0xe2, 0x78, 0x01, 0xc0, 0x02, 
  /* 0x0160 */ 0x5d, 0x01, 0x03, 0x62, 0x14, 0xd9, 0x6c, 0xe0, 0x79, 0x01, 0xc0, 0x06, 0xd7, 0x4f, 0xe1, 0xcc, 
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
  Serial.println(buf);
  if (writeErrors > 0) {
    sprintf(buf, "\r\nERR: %d\r\n", writeErrors);
    Serial.println(buf);    
  }
  Serial.println(F("done."));
  printContents(0x1f00);
}

void loop() {
  // put your main code here, to run repeatedly:

}
