DerULF1/8bit-computer/Sketches/Test74HC595/Test74HC595.ino

#define SHIFT_DATA 2
#define SHIFT_CLK 3
#define SHIFT_LATCH 4
#define DATA_D0 5
#define DATA_D7 12
#define WRITE_ENABLE 13

void setAddress(int address) {
  shiftOut(SHIFT_DATA, SHIFT_CLK, MSBFIRST, (address >> 8));
  shiftOut(SHIFT_DATA, SHIFT_CLK, MSBFIRST, address);

  digitalWrite(SHIFT_LATCH, LOW);
  digitalWrite(SHIFT_LATCH, HIGH);
  digitalWrite(SHIFT_LATCH, LOW);
}

void writeData(int address, byte odata) {
  setDataPinMode(OUTPUT);
  setAddress(address);

  byte data = odata;
  for (int pin = DATA_D7; pin >= DATA_D0; pin--) {
    digitalWrite(pin, data & 0x80);
    data = data << 1;
  }
  digitalWrite(WRITE_ENABLE, HIGH);
  delay(1);
  digitalWrite(WRITE_ENABLE, LOW);

}

void setDataPinMode(int mode) {
  for (int pin = DATA_D7; pin >= DATA_D0; pin--) {
    pinMode(pin, mode);
  }
}

// All Halt
const byte xpgmData[] PROGMEM = {
  /* 0x00 */ 0x6a, 0x13, 0x71, 0x00, 0x5c, 0x01, 0x02, 0x99, 0x6b, 0x01, 0xdc, 0x07, 0x00, 0x72, 0x00, 0xdc, 
  /* 0x10 */ 0x07, 0x00, 0x01
};

// Fibonacci
const byte  ypgmData[] PROGMEM = {
  /* 0x00 */ 0x5c, 0x00, 0x63, 0x01, 0x02, 0xb9, 0x32, 0x3a, 0x08, 0x24, 0xdc, 0x05, 0x00, 0x72, 0x00, 0xdd, 
  /* 0x10 */ 0x00, 0x00, 0x01, 0xd6, 0x00, 0x00
};

//Stacktest
const byte zpgmData[] PROGMEM = {
  /* 0x00 */ 0x63, 0x00, 0x6a, 0x00, 0x5c, 0x00, 0xca, 0xd7, 0x1e, 0x00, 0xcb, 0x02, 0x5d, 0x01, 0xdc, 0x06, 
  /* 0x10 */ 0x00, 0x64, 0x00, 0xdc, 0x06, 0x00, 0x6b, 0x00, 0xdd, 0x06, 0x00, 0x01, 0xb8, 0x06, 0x02, 0x5d, 
  /* 0x20 */ 0x01, 0xd2, 0xd7, 0x1c, 0x00, 0xd3, 0xd9, 0x2c, 0x00, 0xd7, 0x1e, 0x00, 0x06
};

//Shifttest
const byte apgmData[] PROGMEM = {
  /* 0x00 */ 0x5c, 0x00, 0x79, 0x32, 0x00, 0x79, 0x33, 0x00, 0xb8, 0x5c, 0x00, 0x1d, 0x32, 0x47, 0x03, 0xbe, 
  /* 0x10 */ 0xbf, 0xc0, 0xc1, 0xdc, 0x0f, 0x00, 0xc7, 0xc6, 0xc5, 0xc4, 0xdc, 0x16, 0x00, 0x78, 0x32, 0x00, 
  /* 0x20 */ 0x5d, 0x00, 0xb8, 0x79, 0x32, 0x00, 0x78, 0x33, 0x00, 0x5d, 0x00, 0x79, 0x33, 0x00, 0xdc, 0x09, 
  /* 0x30 */ 0x00, 0x01, 0x00, 0x00
};

//Prime32
const byte bpgmData[] PROGMEM = {
  /* 0x000 */ 0xd7, 0x8c, 0x02, 0x5c, 0x03, 0x79, 0xbe, 0x02, 0x5c, 0x00, 0x79, 0xbf, 0x02, 0x79, 0xc0, 0x02, 
  /* 0x010 */ 0x79, 0xc1, 0x02, 0x5c, 0x02, 0xb8, 0xd7, 0x80, 0x02, 0xdc, 0x5a, 0x00, 0xd7, 0x51, 0x02, 0x5c, 
  /* 0x020 */ 0xca, 0x79, 0xc6, 0x02, 0x5c, 0x02, 0x79, 0xc7, 0x02, 0xd7, 0x6f, 0x02, 0xd9, 0x47, 0x00, 0xd7, 
  /* 0x030 */ 0x2d, 0x02, 0xd7, 0xf1, 0x01, 0xdc, 0x47, 0x00, 0xd7, 0x5b, 0x00, 0xd7, 0xd8, 0x01, 0xd9, 0x54, 
  /* 0x040 */ 0x00, 0xd7, 0xc6, 0x01, 0xd6, 0x29, 0x00, 0xd7, 0x88, 0x01, 0x80, 0xbc, 0x02, 0x78, 0xbe, 0x02, 
  /* 0x050 */ 0xb8, 0xd6, 0x54, 0x00, 0xd7, 0x0b, 0x02, 0xdc, 0x16, 0x00, 0x01, 0x78, 0xbe, 0x02, 0x79, 0x9f, 
  /* 0x060 */ 0x02, 0x78, 0xbf, 0x02, 0x79, 0xa0, 0x02, 0x78, 0xc0, 0x02, 0x79, 0xa1, 0x02, 0x78, 0xc1, 0x02, 
  /* 0x070 */ 0x79, 0xa2, 0x02, 0x78, 0x9f, 0x02, 0x79, 0xa7, 0x02, 0x78, 0xa0, 0x02, 0x79, 0xa8, 0x02, 0x78, 
  /* 0x080 */ 0xa1, 0x02, 0x79, 0xa9, 0x02, 0x78, 0xa2, 0x02, 0x79, 0xaa, 0x02, 0x5c, 0x00, 0x79, 0xab, 0x02, 
  /* 0x090 */ 0x79, 0xac, 0x02, 0x79, 0xad, 0x02, 0x79, 0xae, 0x02, 0x5c, 0x20, 0x79, 0xbb, 0x02, 0x02, 0xc2, 
  /* 0x0a0 */ 0xa7, 0x02, 0xc2, 0xa8, 0x02, 0xc2, 0xa9, 0x02, 0xc2, 0xaa, 0x02, 0xc2, 0xab, 0x02, 0xc2, 0xac, 
  /* 0x0b0 */ 0x02, 0xc2, 0xad, 0x02, 0xc2, 0xae, 0x02, 0x03, 0x78, 0xab, 0x02, 0x7b, 0xa3, 0x02, 0x80, 0xac, 
  /* 0x0c0 */ 0x02, 0x83, 0xa4, 0x02, 0x88, 0xad, 0x02, 0x8b, 0xa5, 0x02, 0x90, 0xae, 0x02, 0x93, 0xa6, 0x02, 
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

  int a = 0;
  int i = 0;
  while (i < sizeof(pgmData)) {
    byte bb = __LPM((uint16_t)(pgmData + i));
    i++;
    writeData(a++, bb);
    delay(1);
  }
  setDataPinMode(INPUT);
  setAddress(0);
}

void loop() {
  // put your main code here, to run repeatedly:

}
