DerULF1/8bit-computer/(commit log)

2020-11-12 SPI Receive Micro Code
2021-05-10 early stage BOM
    [BOM.csv]
2025-10-18 switch to java-based Micro Code generator
2025-10-18 EEPROMer Schematics
2025-10-18 Some Sample Code for the 8-Bit-CPU
